hidroel/Staj-2023/documents/images/2023-staj-projesi.png

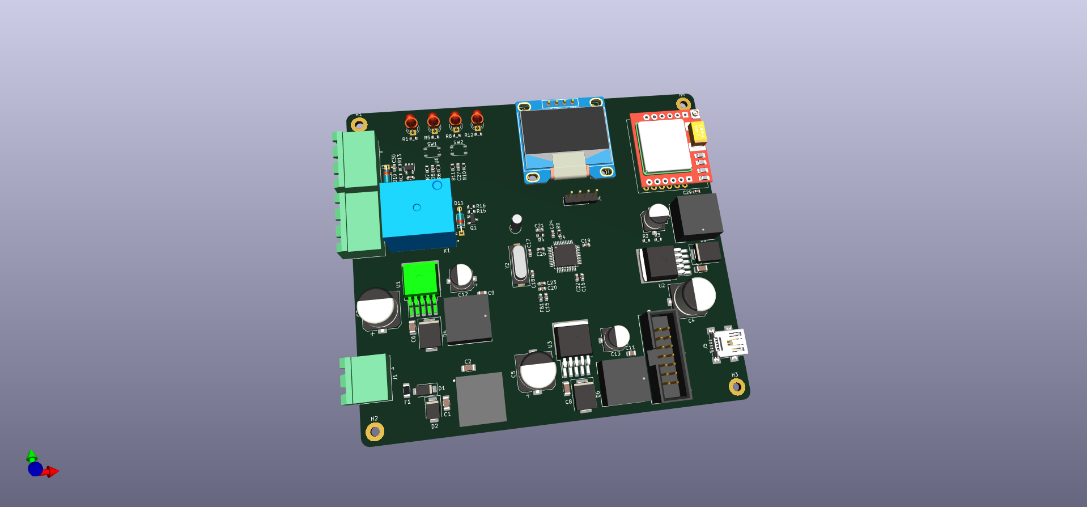
documents/images/2023-staj-projesi.png
