hidroel/Staj-2023/hardware/2023-staj-projesi.kicad_pcb

## KiCad design hardware/2023-staj-projesi.kicad_pcb (2023-08-10)

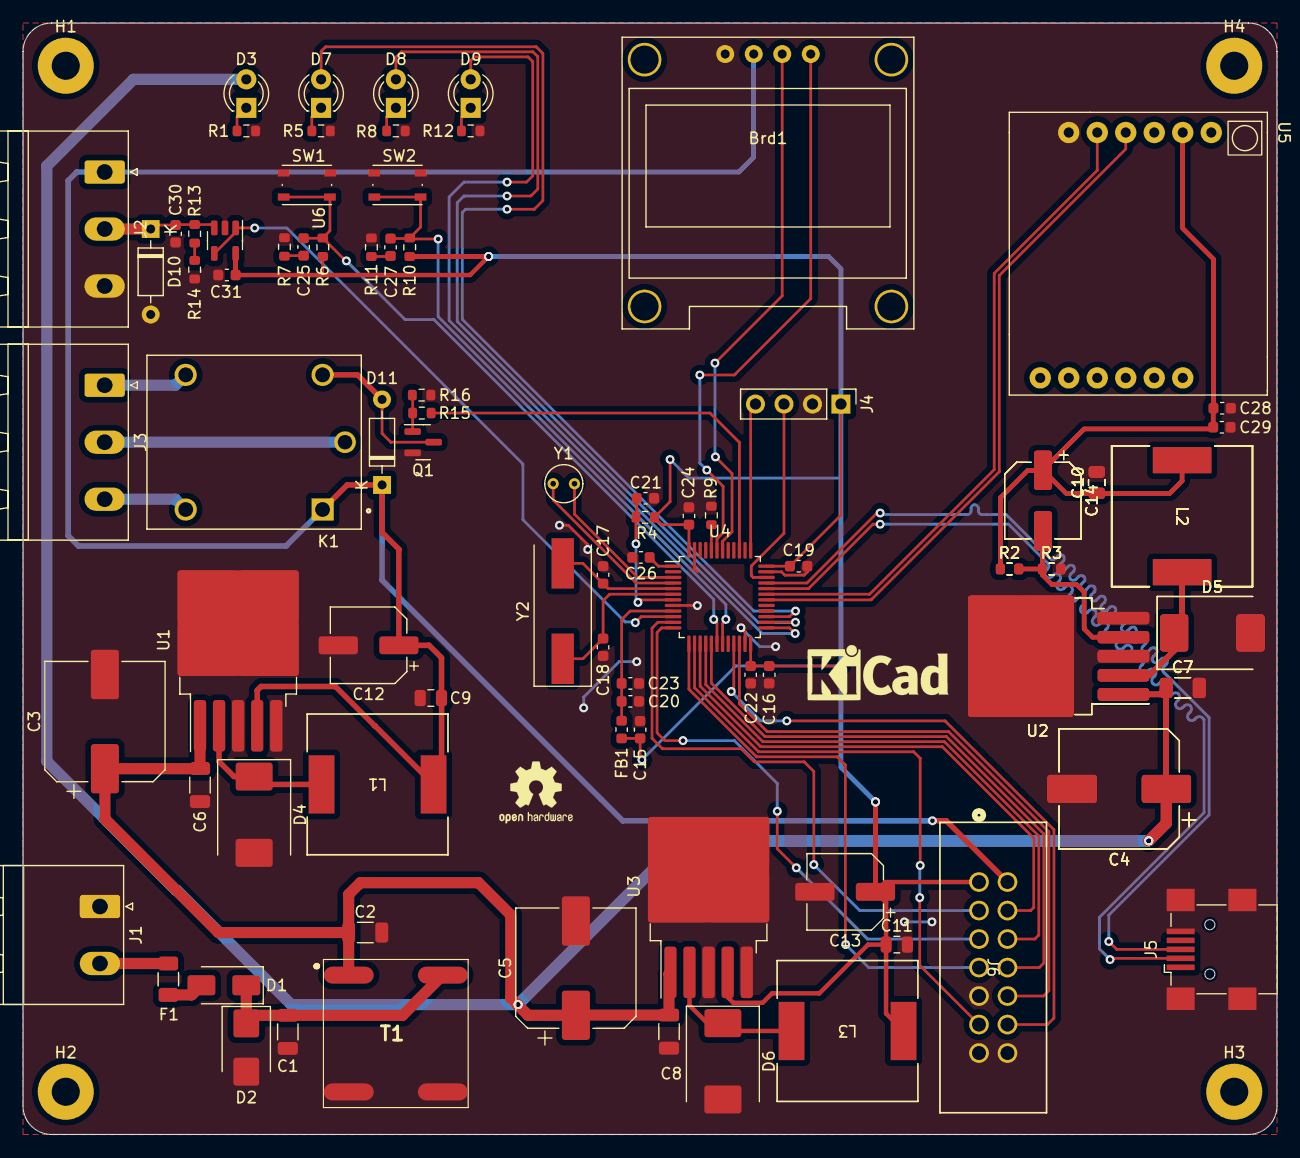
[picture p9: board 2023-staj-projesi.kicad_pcb from above]

Board: 2 copper layers, 111.8 x 99.1 mm, 96 parts (0 on the bottom side), 57 nets.

Parts:
Brd1: SSD1306; SSD1306_0.96_Oled
C1, C2: CL31B104KBCNFNC; C_1206_3216Metric
C3, C4, C4#2, C5: 100uF/63V; CP_Elec_10x10.5
C6, C7, C7#2, C8: 470nF/100V; C_1206_3216Metric
C9, C10, C10#2, C11: 100nF/20V; C_0805_2012Metric
C12, C13, C14, C14#2: 100uF/20V; CP_Elec_6.3x7.7
C15, C20, C28: 1uF; C_0603_1608Metric
C16: 10uF; C_0603_1608Metric
C17, C18: 20pF; C_0603_1608Metric
C19, C21, C22, C24, C25, C27, C29, C31: 100nF; C_0603_1608Metric
C23, C30: 10nF; C_0603_1608Metric
C26: 1uF/10V; C_0603_1608Metric
D1: SBR3A40SAQ; D_SMA
D2: SMBJ28A; D_SMB
D3: LED_PWR; LED_D3.0mm
D4, D5, D5#2, D6: SK56; D_SMC
D7: LED_ACT; LED_D3.0mm
D8: LED_DEACT; LED_D3.0mm
D9: LED_ERR; LED_D3.0mm
D10: SMBJ28A; D_DO-35_SOD27_P7.62mm_Horizontal
D11: 1N4148; D_DO-35_SOD27_P7.62mm_Horizontal
F1: Fuse; Fuse_1206_3216Metric
FB1: 120R; L_0603_1608Metric
H1, H2, H3, H4: MountingHole; MountingHole_2.5mm_Pad
J1: POWER; PhoenixContact_MSTBA_2,5_2-G-5,08_1x02_P5.08mm_Horizontal
J2: SENSOR; PhoenixContact_MSTBA_2,5_3-G-5,08_1x03_P5.08mm_Horizontal
J3: RELAY; PhoenixContact_MSTBA_2,5_3-G-5,08_1x03_P5.08mm_Horizontal
J4: SW; PinHeader_1x04_P2.54mm_Vertical
J5: USB_B_Mini; USB_Mini-B_Wuerth_65100516121_Horizontal
J6: EXT; CONN14_1421621_WRE
K1: SRD-05VDC-SL-C; RELAY_SRD-05VDC-SL-C
L1, L2, L2#2, L3: 74477020; IND_1280-WE-PD_WRE
Q1: BC847; SOT-23
R1: 1K2; R_0603_1608Metric
R2, R2#2: 2K2; R_0603_1608Metric
R3, R3#2: 1K; R_0603_1608Metric
R4: 10K; R_0603_1608Metric
R5, R8, R12: 470R; R_0603_1608Metric
R6, R10, R15: 4K7; R_0603_1608Metric
R7, R11: 100R; R_0603_1608Metric
R9: 100K; R_0603_1608Metric
R13: 150R; R_0603_1608Metric
R14: 15R; R_0603_1608Metric
R16: 47K; R_0603_1608Metric
SW1: BTN_ACT; SW_Push_1P1T_NO_Vertical_Wuerth_434133025816
SW2: BTN_DEACT; SW_Push_1P1T_NO_Vertical_Wuerth_434133025816
T1: PA2748NL
U1: LM2596S-5; TO-263-5_TabPin3
U2, U2#2: LM2596S-ADJ; TO-263-5_TabPin3
U3: LM2596S-3.3; TO-263-5_TabPin3
U4: STM32F103C8T6; LQFP-48_7x7mm_P0.5mm
U5: SIM800L-CORE
U6: AD8603; TSOT-23-5
Y1: 32KHz; Crystal_C38-LF_D3.0mm_L8.0mm_Vertical
Y2: 8MHz; Crystal_SMD_HC49-SD

Connections:
+3.3VA: C20.1, C23.1, FB1.2, U4.9 (VDDA)
+3V3: C11.1, C13.1, C15.1, C16.1, C19.1, C22.1, C24.1, C31.1, FB1.1, J4.1, J6.1, L3.1, R4.2, R6.1, R10.1, U3.4 (FB), U4.24 (VDD), U4.36 (VDD), U4.48 (VDD), U6.5 (V+)
+3V8: C10.1, C10#2.1, C14.1, C14#2.1, C28.1, C29.1, L2.1, L2#2.1, R2.1, R2#2.1, U5.2 (VCC)
+5V: Brd1.2 (VCC), C9.1, C12.1, D11.1 (K), J2.1, J6.2, K1.A1, L1.1, U1.4 (FB)
/ADC/ADC: U4.10 (PA0), U6.1, U6.4 (-)
/ADC/SENSOR: C30.1, D10.1 (K), J2.2, R13.1, U6.3 (+)
/GSM/RXD: U4.30 (PA9), U5.4 (RXD)
/GSM/TXD: U4.31 (PA10), U5.5 (TXD)
/LCD/SCL: Brd1.3 (SCL), U4.42 (PB6)
/LCD/SDA: Brd1.4 (SDA), U4.43 (PB7)
/MCU/BOOT: R9.1, U4.44 (BOOT0)
/MCU/BTN_ACT: C25.1, R6.2, SW1.2, U4.18 (PB0)
/MCU/BTN_DEACT: C27.1, R10.2, SW2.2, U4.19 (PB1)
/MCU/I2C2_SCL: J6.12, U4.21 (PB10)
/MCU/I2C2_SDA: J6.10, U4.22 (PB11)
/MCU/LED_ACT: D7.2 (A), U4.27 (PB14)
/MCU/LED_DEACT: D8.2 (A), U4.26 (PB13)
/MCU/LED_ERR: D9.2 (A), U4.25 (PB12)
/MCU/NRST: C21.1, R4.1, U4.7 (NRST)
/MCU/PA1: J6.3, U4.11 (PA1)
/MCU/PA4: J6.11, U4.14 (PA4)
/MCU/RCC_OSC32_IN: U4.3 (PC14), Y1.2
/MCU/RCC_OSC32_OUT: U4.4 (PC15), Y1.1
/MCU/RCC_OSC_IN: C17.2, U4.5 (PD0), Y2.2
/MCU/RCC_OSC_OUT: C18.2, U4.6 (PD1), Y2.1
/MCU/RELAY: R15.1, U4.39 (PB3)
/MCU/SPI1_MISO: J6.6, U4.16 (PA6)
/MCU/SPI1_MOSI: J6.8, U4.17 (PA7)
/MCU/SPI1_SCK: J6.4, U4.15 (PA5)
/MCU/SWCLK: J4.4, U4.37 (PA14)
/MCU/SWDIO: J4.3, U4.34 (PA13)
/MCU/USART2_RX: J6.7, U4.13 (PA3)
/MCU/USART2_TX: J6.5, U4.12 (PA2)
/MCU/USB_D+: J5.3 (D+), U4.33 (PA12)
/MCU/USB_D-: J5.2 (D-), U4.32 (PA11)
/MCU/VBAT: C26.1, U4.1 (VBAT)
/Power/+12V: C2.1, C3.1, C4.1, C4#2.1, C5.1, C6.1, C7.1, C7#2.1, C8.1, D3.2 (A), T1.1 (PRI_1), U1.1 (VIN), U2.1 (VIN), U2#2.1 (VIN), U3.1 (VIN)
/Power/VCC: F1.1, J1.2
/RELAY/RLIN: J3.2, K1.COM
/RELAY/RLNC: J3.3, K1.NC
/RELAY/RLNO: J3.1, K1.NO
GND: Brd1.1 (GND), C1.2, C2.2, C3.2, C4.2, C4#2.2, C5.2, C6.2, C7.2, C7#2.2, C8.2, C9.2, C10.2, C10#2.2, C11.2, C12.2, C13.2, C15.2, C16.2, C17.1, C18.1, C19.2, C20.2, C21.2, C22.2, C23.2, C24.2, C26.2, C28.2, C29.2, C30.2, C31.2, D2.2 (A), D4.2 (A), D5.2 (A), D5#2.2 (A), D6.2 (A), D10.2 (A), J1.1, J2.3, J4.2, J5.5 (GND), J5.6 (Shield), J6.9, J6.13, J6.14, Q1.2 (E), R1.2, R3.2, R3#2.2, R5.2, R7.2, R8.2, R9.2, R11.2, R12.2, R14.2, R16.2, SW1.1, SW2.1, T1.2 (PRI_2), T1.4 (SEC_2), U1.3 (GND), U1.5 (~ON/OFF), U2.3 (GND), U2.5 (~ON/OFF), U2#2.3 (GND), U2#2.5 (~ON/OFF), U3.3 (GND), U3.5 (~ON/OFF), U4.8 (VSSA), U4.23 (VSS), U4.35 (VSS), U4.47 (VSS), U5.6 (GND), U6.2 (V-)
unnamed: C25.2, R7.1
unnamed: C27.2, R11.1
unnamed: D1.2 (A), F1.2
unnamed: C1.1, D1.1 (K), D2.1 (K), T1.3 (SEC_1)
unnamed: D3.1 (K), R1.1
unnamed: D4.1 (K), L1.2, U1.2 (OUT)
unnamed: D5.1 (K), D5#2.1 (K), L2.2, L2#2.2, U2.2 (OUT), U2#2.2 (OUT)
unnamed: D6.1 (K), L3.2, U3.2 (OUT)
unnamed: D7.1 (K), R5.1
unnamed: D8.1 (K), R8.1
unnamed: D9.1 (K), R12.1
unnamed: D11.2 (A), K1.A2, Q1.3 (C)
unnamed: Q1.1 (B), R15.2, R16.1
unnamed: R13.2, R14.1
unnamed: C14.2, C14#2.2, R2.2, R2#2.2, R3.1, R3#2.1, U2.4 (FB), U2#2.4 (FB)
