hidroel/Staj-2023/firmware/2023-staj-projesi/2023-staj-projesi.ioc

Mcu.UserName=STM32F103C8Tx
PA0-WKUP.Signal=ADCx_IN0
PA1.GPIO_Label=PA1
PA1.Signal=GPIO_Output
PA10.Signal=USART1_RX
PA11.Signal=USB_DM
PA12.Signal=USB_DP
PA13.Signal=SYS_JTMS-SWDIO
PA14.Signal=SYS_JTCK-SWCLK
PA2.Signal=USART2_TX
PA3.Signal=USART2_RX
PA4.GPIO_Label=PA4
PA4.Signal=GPIO_Output
PA5.Signal=SPI1_SCK
PA6.Signal=SPI1_MISO
PA7.Signal=SPI1_MOSI
PA9.Signal=USART1_TX
PB0.GPIO_Label=BTN_ACT
PB0.Signal=GPXTI0
PB1.GPIO_Label=BTN_DEACT
PB1.Signal=GPXTI1
PB10.Signal=I2C2_SCL
PB11.Signal=I2C2_SDA
PB12.GPIO_Label=LED_ERR
PB12.Signal=GPIO_Output
PB13.GPIO_Label=LED_DEACT
PB13.Signal=GPIO_Output
PB14.GPIO_Label=LED_ACT
PB14.Signal=GPIO_Output
PB3.GPIO_Label=RELAY
PB3.Signal=GPIO_Output
PB6.GPIO_Label=LCD_SCL
PB6.Signal=I2C1_SCL
PB7.GPIO_Label=LCD_SDA
PB7.Signal=I2C1_SDA
PC14-OSC32_IN.Signal=RCC_OSC32_IN
PC15-OSC32_OUT.Signal=RCC_OSC32_OUT
PD0-OSC_IN.Signal=RCC_OSC_IN
PD1-OSC_OUT.Signal=RCC_OSC_OUT
