hidroel/Staj-2023/firmware/2023-staj-projesi/Core/Inc/main.h

#define PA1_Pin GPIO_PIN_1
#define PA1_GPIO_Port GPIOA
#define PA4_Pin GPIO_PIN_4
#define PA4_GPIO_Port GPIOA
#define BTN_ACT_Pin GPIO_PIN_0
#define BTN_ACT_GPIO_Port GPIOB
#define BTN_DEACT_Pin GPIO_PIN_1
#define BTN_DEACT_GPIO_Port GPIOB
#define LED_ERR_Pin GPIO_PIN_12
#define LED_ERR_GPIO_Port GPIOB
#define LED_DEACT_Pin GPIO_PIN_13
#define LED_DEACT_GPIO_Port GPIOB
#define LED_ACT_Pin GPIO_PIN_14
#define LED_ACT_GPIO_Port GPIOB
#define RELAY_Pin GPIO_PIN_3
#define RELAY_GPIO_Port GPIOB
#define LCD_SCL_Pin GPIO_PIN_6
#define LCD_SCL_GPIO_Port GPIOB
#define LCD_SDA_Pin GPIO_PIN_7
#define LCD_SDA_GPIO_Port GPIOB
