hidroel/Staj-2023/(commit log)

2023-07-31 * 3V8 Power design fixed * Footprints assigned * Bom exported * PCB filter module placed
    [2023-staj-projesi-1.csv, 2023-staj-projesi-2.csv, 2023-staj-projesi.kicad_pcb, 2023-staj-projesi.kicad_sch, adc.kicad_sch, bom.xlsx, gsm.kicad_sch, lcd.kicad_sch]
2023-08-05 PCB 5V power placed
    [2023-staj-projesi.kicad_pcb]
2023-08-06 3.3 and 3.8 volts placed on the pcb
    [2023-staj-projesi.kicad_pcb]
2023-08-08 PCB design completed
    [2023-staj-projesi.kicad_pcb, mcu.kicad_sch, power.kicad_sch]
2023-08-10 Added PCB names and logos
    [2023-staj-projesi-B_Cu.gbr, 2023-staj-projesi-B_Mask.gbr, 2023-staj-projesi-B_Paste.gbr, 2023-staj-projesi-B_Silkscreen.gbr, 2023-staj-projesi-Edge_Cuts.gbr, 2023-staj-projesi-F_Cu.gbr, 2023-staj-projesi-F_Mask.gbr, 2023-staj-projesi-F_Paste.gbr]
