hidroel/Staj-2023/(notices)

Notices in the files:
firmware/2023-staj-projesi/Core/Inc/main.h:
Copyright (c) 2023 STMicroelectronics.
All rights reserved.
This software is licensed under terms that can be found in the LICENSE file
